GRiM-01/Radar-Security-System/circuitDiagram.png

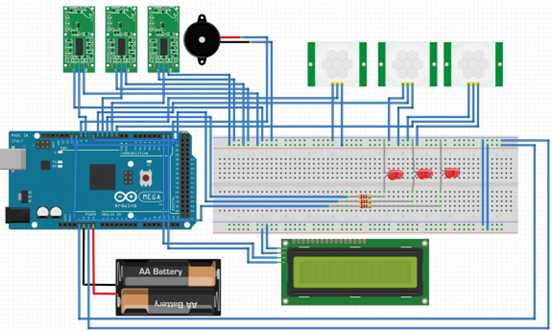
circuitDiagram.png
