GRiM-01/Radar-Security-System/circuitSchematic.png

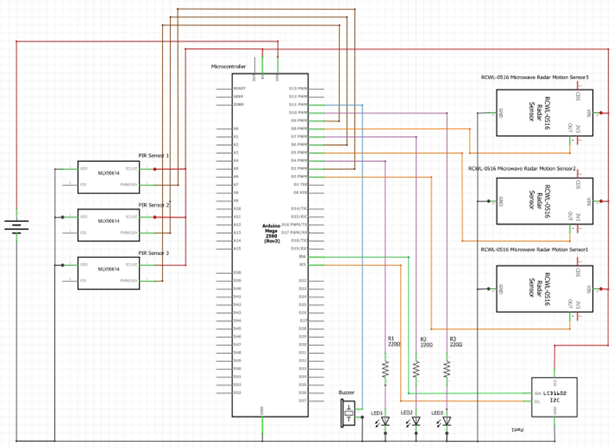
circuitSchematic.png
