GRiM-01/Radar-Security-System/wiringTable.png

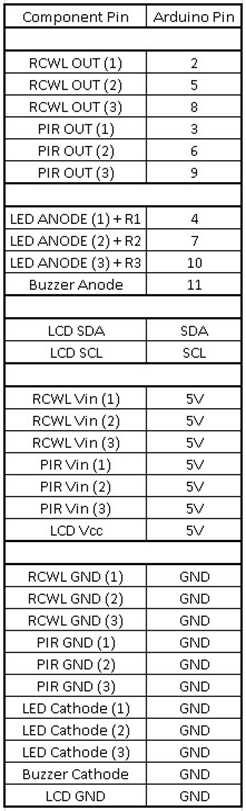
wiringTable.png
